laurent68k/RedBoard6809-1/Hardware/Gallery/P2240087.jpg

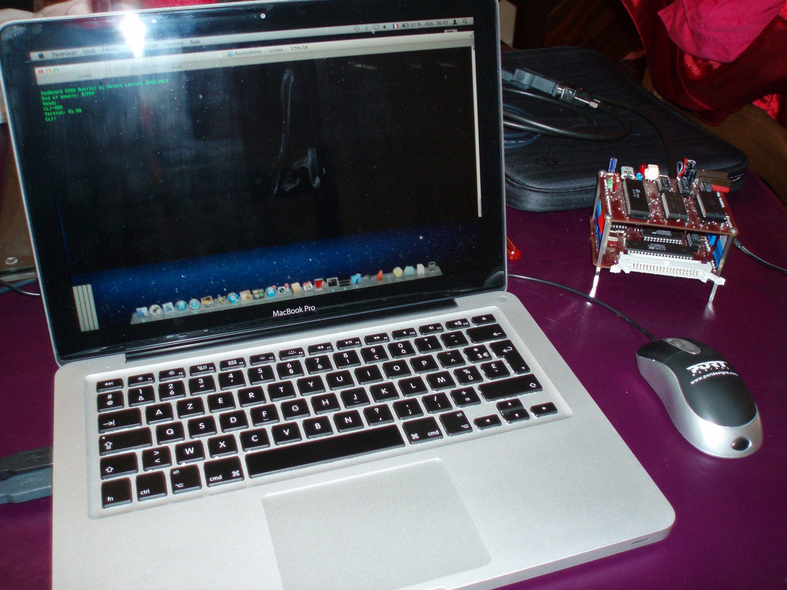
Hardware/Gallery/P2240087.jpg
