laurent68k/RedBoard6809-1/Hardware/Gallery/RBMonitor01.png

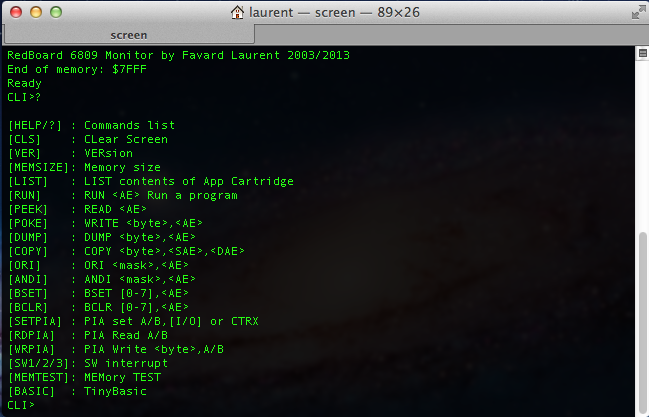
Hardware/Gallery/RBMonitor01.png
