laurent68k/RedBoard6809-1/Hardware/Gallery/P2240088.jpg

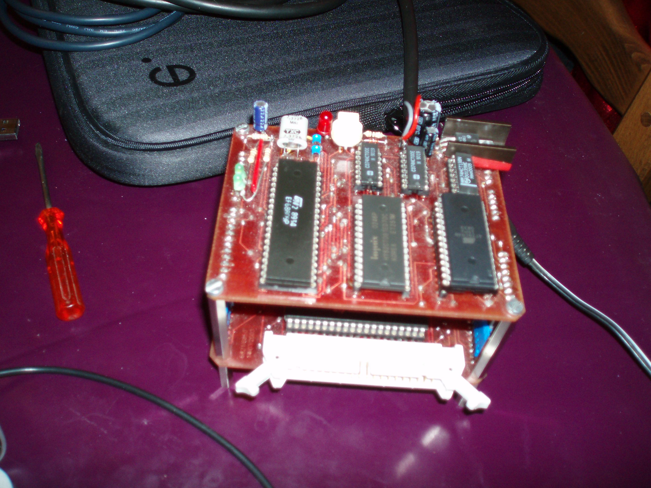
Hardware/Gallery/P2240088.jpg
