laurent68k/RedBoard6809-1/Hardware/Gallery/P3100010.jpg

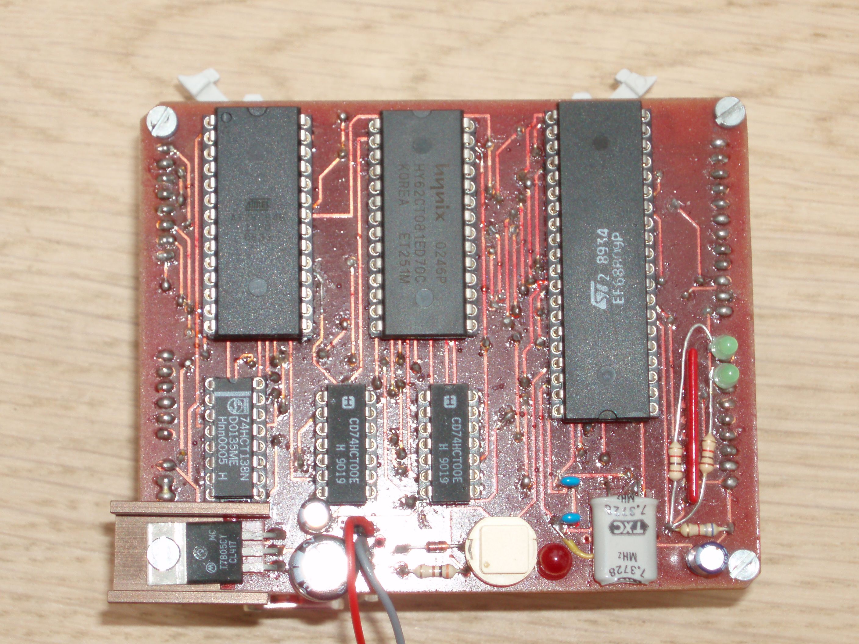
Hardware/Gallery/P3100010.jpg
