laurent68k/RedBoard6809-1/Hardware/Gallery/P3100011.jpg

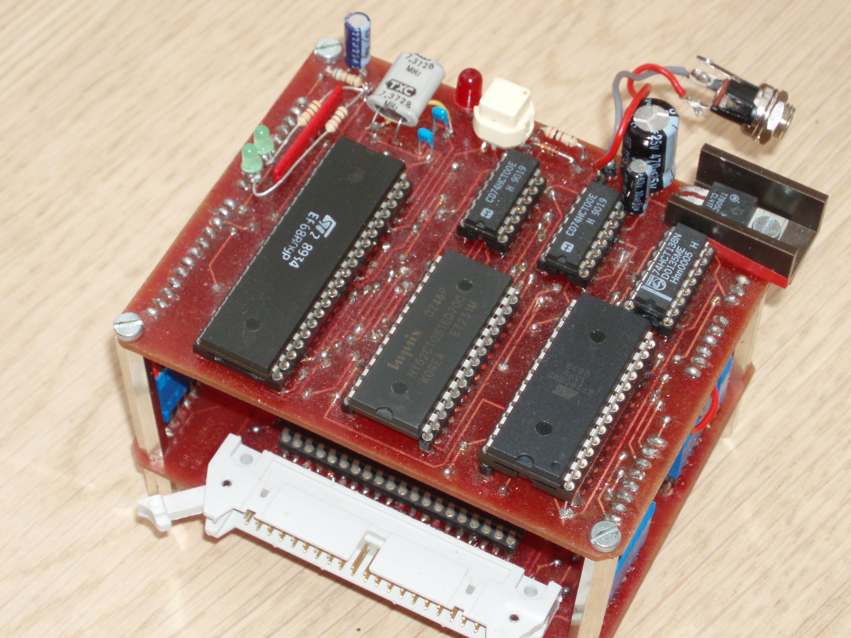
Hardware/Gallery/P3100011.jpg
