laurent68k/RedBoard6809-1/Hardware/Gallery/P3100013.jpg

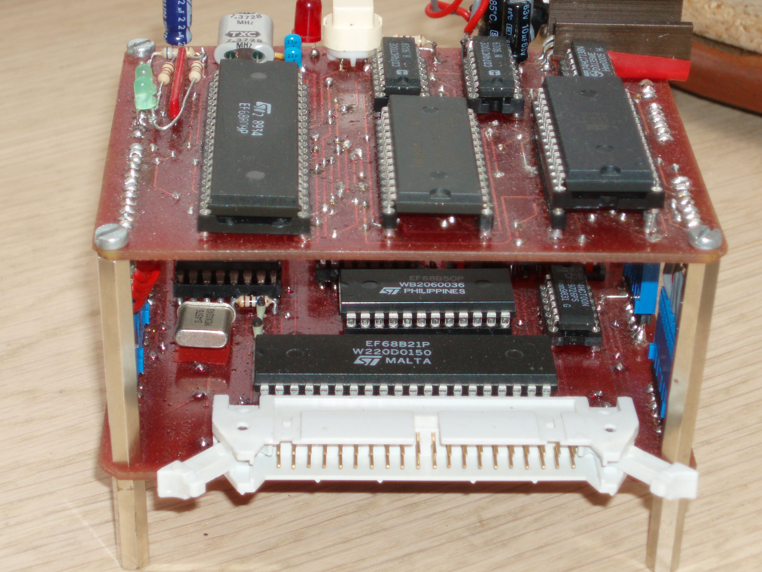
Hardware/Gallery/P3100013.jpg
