laurent68k/RedBoard6809-1/Hardware/Gallery/PC290011.jpg

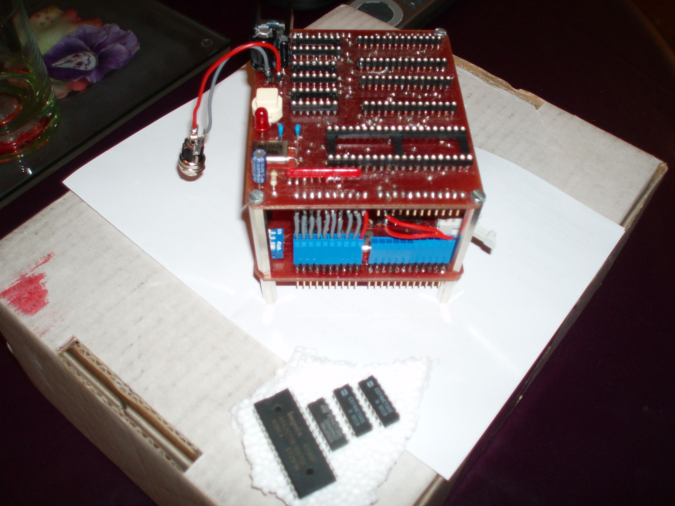
Hardware/Gallery/PC290011.jpg
