laurent68k/RedBoard6809-1/Hardware/Gallery/PC300019.jpg

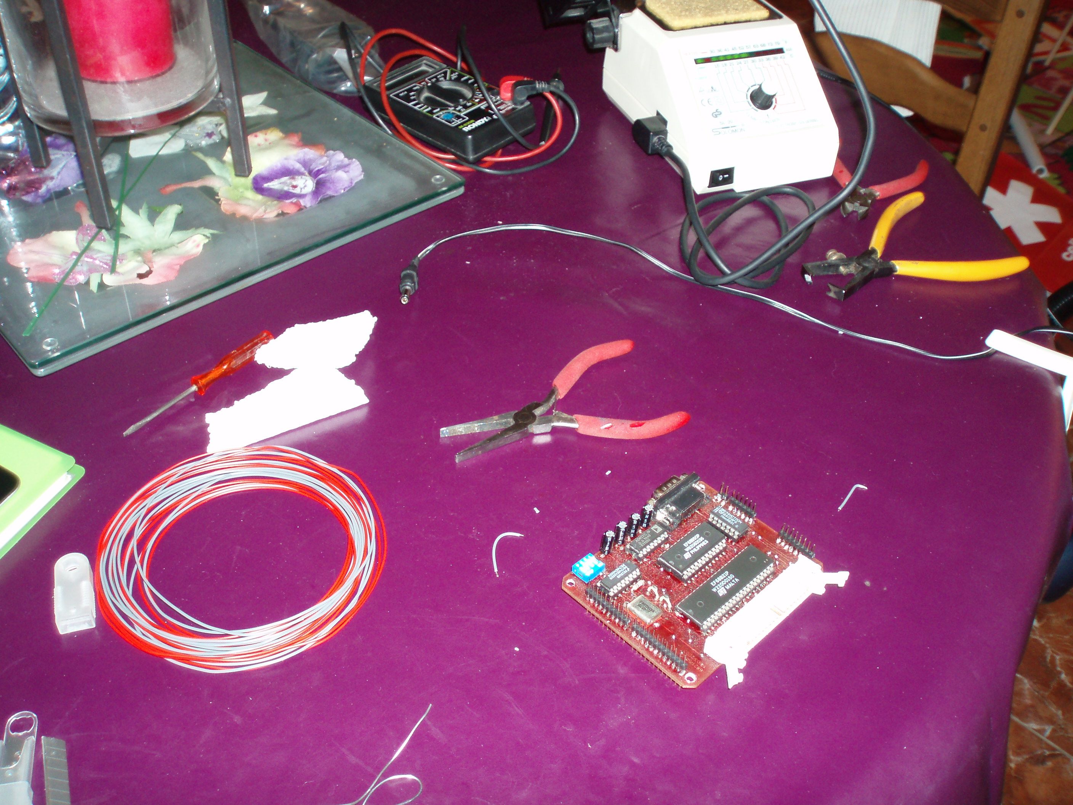
Hardware/Gallery/PC300019.jpg
