laurent68k/RedBoard6809-1/Hardware/Gallery/RBMonitor02.png

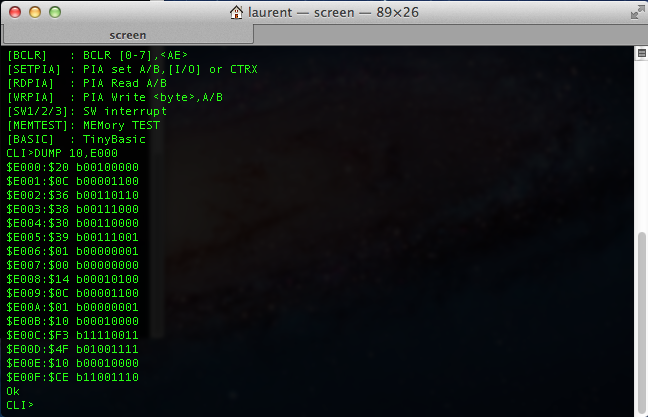
Hardware/Gallery/RBMonitor02.png
