laurent68k/RedBoard6809-1/Hardware/Gallery/RBMonitor03.png

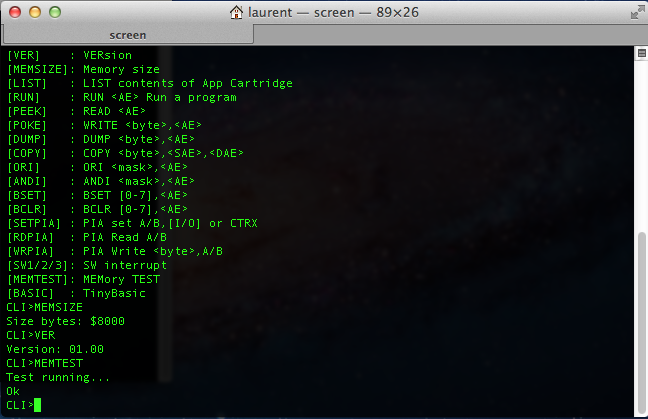
Hardware/Gallery/RBMonitor03.png
