laurent68k/RedBoard6809-1/Hardware/Schematics/CPU-68B09P.png

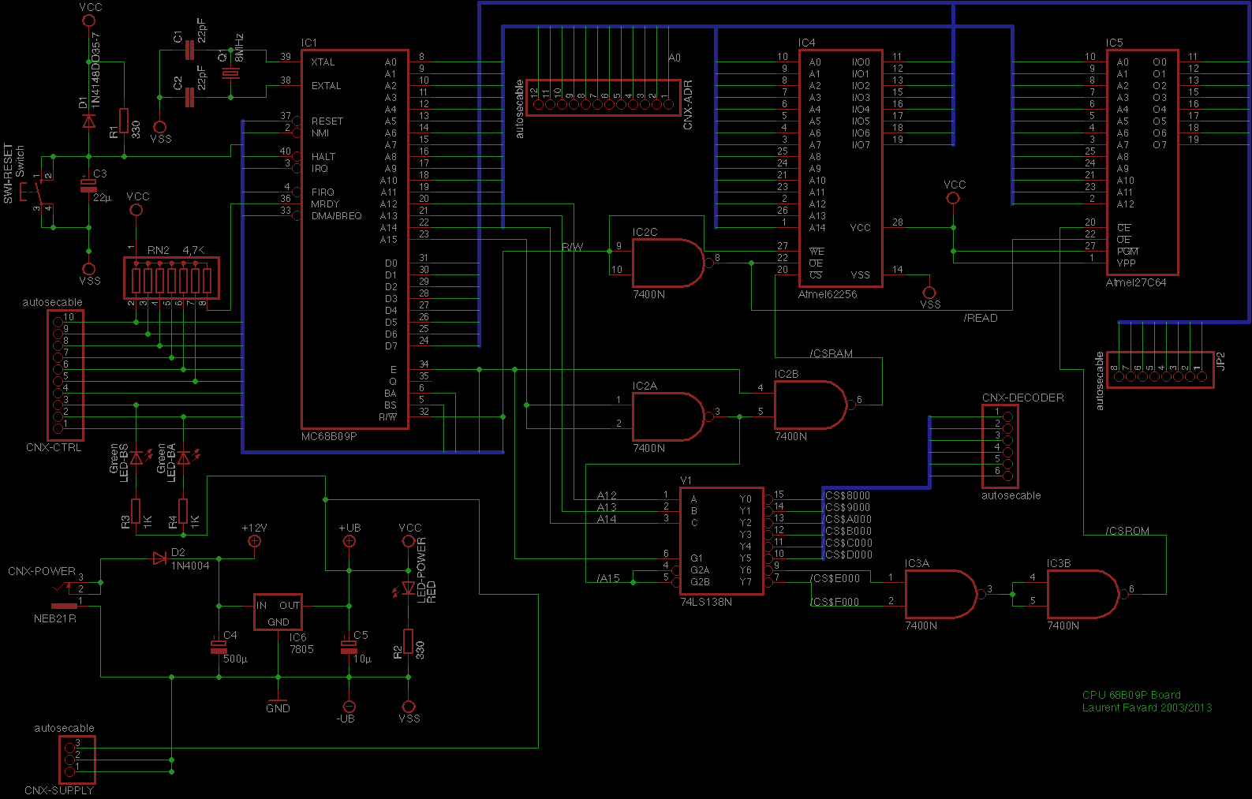
Hardware/Schematics/CPU-68B09P.png
