laurent68k/RedBoard6809-1/Hardware/Schematics/IO-68B50-68B21.jpeg

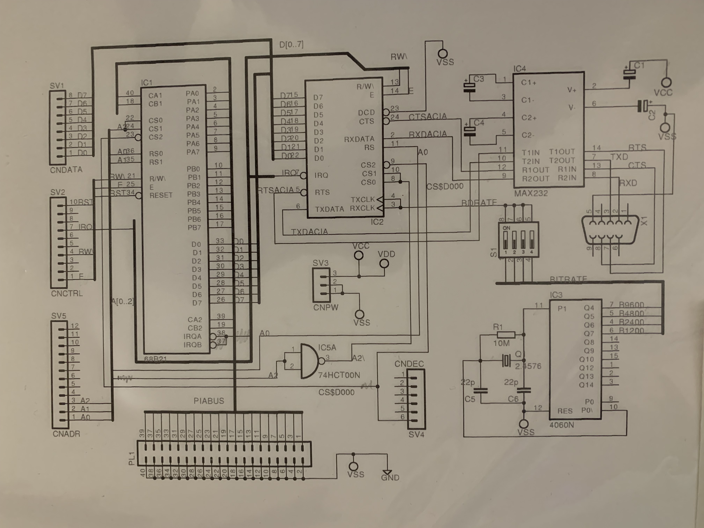
Hardware/Schematics/IO-68B50-68B21.jpeg
