laurent68k/RedBoard6809-1/Hardware/Schematics/eagle/RedBoardCPU6809.sch

## EAGLE design Hardware/Schematics/eagle/RedBoardCPU6809.sch (2025-07-22)

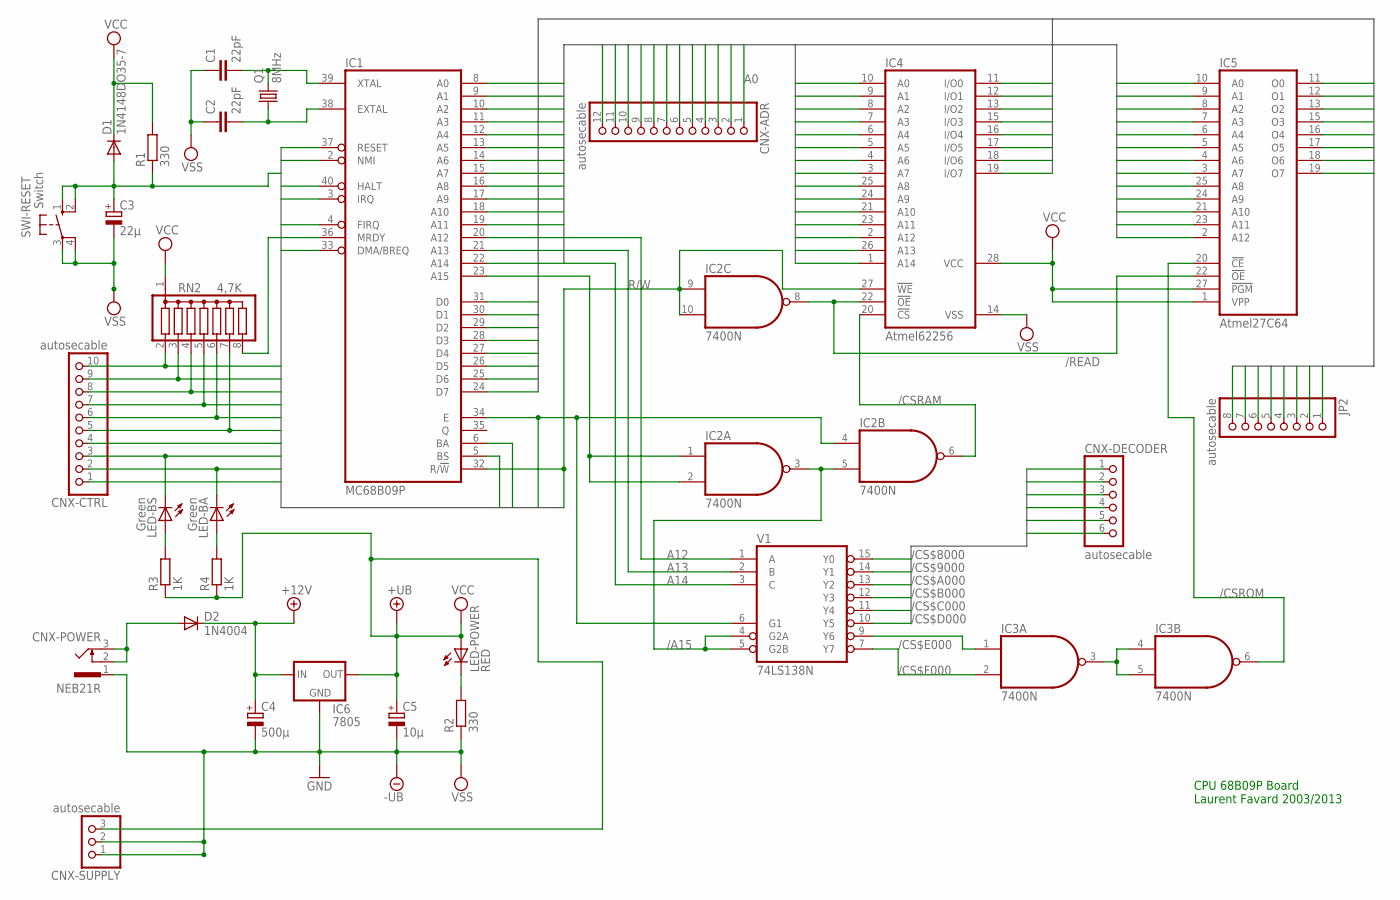
[picture p23: schematic RedBoardCPU6809.sch]

Parts:
C1, C2: 22pF; C2.5-3
C3: 22µ; E2-5
C4: 500µ; E2-5
C5: 10µ; E2-5
CNX-ADR: autosecable; 1X12
CNX-CTRL: autosecable; 1X10
CNX-DECODER: autosecable; 1X06
CNX-POWER: NEB21R
CNX-SUPPLY: autosecable; 1X03
D1: 1N4148DO35-7; DO35-7
D2: 1N4004; DO41-10
IC1: MC68B09P; DIL40
IC2, IC3: 7400N; DIL14
IC4: Atmel62256; DIL28-6
IC5: Atmel27C64; DIL28
IC6: 7805; 78XXL
JP2: autosecable; 1X08
LED-BA: Green; LED3MM
LED-BS: Green; LED3MM
LED-POWER: RED; LED3MM
Q1: 8MHz; HC18U-H
R1, R2: 330; 0207/12
R3, R4: 1K; 0207/12
RN2: 4,7K; SIL8
SWI-RESET: Switch; B3F-10XX
V1: 74LS138N; DIL16

Connections:
+12V: C4.+, D2.C, IC6.IN
/A15: IC2.3 (O), IC2.5 (I1), V1.4 (G2A), V1.5 (G2B)
/CS$8000: CNX-DECODER.1, V1.15 (Y0)
/CS$9000: CNX-DECODER.2, V1.14 (Y1)
/CS$A000: CNX-DECODER.3, V1.13 (Y2)
/CS$B000: CNX-DECODER.4, V1.12 (Y3)
/CS$C000: CNX-DECODER.5, V1.11 (Y4)
/CS$D000: CNX-DECODER.6, V1.10 (Y5)
/CS$E000: IC3.1 (I0), V1.9 (Y6)
/CS$F000: IC3.2 (I1), V1.7 (Y7)
/CSRAM: IC2.6 (O), IC4.20 (!CS)
/CSROM: IC3.6 (O), IC5.20 (!CE)
/READ: IC2.8 (O), IC4.22 (!OE), IC5.22 (!OE)
A0: CNX-ADR.1, IC1.8 (A0), IC4.10 (A0), IC5.10 (A0)
A1: CNX-ADR.2, IC1.9 (A1), IC4.9 (A1), IC5.9 (A1)
A2: CNX-ADR.3, IC1.10 (A2), IC4.8 (A2), IC5.8 (A2)
A3: CNX-ADR.4, IC1.11 (A3), IC4.7 (A3), IC5.7 (A3)
A4: CNX-ADR.5, IC1.12 (A4), IC4.6 (A4), IC5.6 (A4)
A5: CNX-ADR.6, IC1.13 (A5), IC4.5 (A5), IC5.5 (A5)
A6: CNX-ADR.7, IC1.14 (A6), IC4.4 (A6), IC5.4 (A6)
A7: CNX-ADR.8, IC1.15 (A7), IC4.3 (A7), IC5.3 (A7)
A8: CNX-ADR.9, IC1.16 (A8), IC4.25 (A8), IC5.25 (A8)
A9: CNX-ADR.10, IC1.17 (A9), IC4.24 (A9), IC5.24 (A9)
A10: CNX-ADR.11, IC1.18 (A10), IC4.21 (A10), IC5.21 (A10)
A11: CNX-ADR.12, IC1.19 (A11), IC4.23 (A11), IC5.23 (A11)
A12: IC1.20 (A12), IC4.2 (A12), IC5.2 (A12), V1.1 (A)
A13: IC1.21 (A13), IC4.26 (A13), V1.2 (B)
A14: IC1.22 (A14), IC4.1 (A14), V1.3 (C)
BA: CNX-CTRL.2, IC1.6 (BA), LED-BA.K (C)
BS: CNX-CTRL.3, IC1.5 (BS), LED-BS.K (C)
D0: IC1.31 (D0), IC4.11 (I/O0), IC5.11 (O0), JP2.1
D1: IC1.30 (D1), IC4.12 (I/O1), IC5.12 (O1), JP2.2
D2: IC1.29 (D2), IC4.13 (I/O2), IC5.13 (O2), JP2.3
D3: IC1.28 (D3), IC4.15 (I/O3), JP2.4
D4: IC1.27 (D4), IC4.16 (I/O4), IC5.15 (O3), IC5.16 (O4), JP2.5
D5: IC1.26 (D5), IC5.17 (O5), JP2.6
D6: IC1.25 (D6), IC4.18 (I/O6), IC5.18 (O6), JP2.7
D7: IC1.24 (D7), IC4.17 (I/O5), IC4.19 (I/O7), IC5.19 (O7), JP2.8
DMA/BREQ: CNX-CTRL.5, IC1.33 (DMA/BREQ), RN2.7
E: CNX-CTRL.1, IC1.34 (E), IC2.4 (I0), V1.6 (G1)
FIRQ: CNX-CTRL.6, IC1.4 (FIRQ), RN2.6
HALT: CNX-CTRL.8, IC1.40 (HALT), RN2.4
IRQ: CNX-CTRL.7, IC1.3 (IRQ), RN2.5
unnamed: C1.2, IC1.39 (XTAL), Q1.2
unnamed: LED-BS.A, R3.2
unnamed: IC1.23 (A15), IC2.1 (I0), IC2.2 (I1)
unnamed: CNX-POWER.2, CNX-POWER.3, D2.A
unnamed: C2.2, IC1.38 (EXTAL), Q1.1
unnamed: LED-BA.A, R4.2
unnamed: LED-POWER.K (C), R2.2
unnamed: IC3.3 (O), IC3.4 (I0), IC3.5 (I1)
unnamed: IC1.36 (MRDY), RN2.8
NMI: CNX-CTRL.9, IC1.2 (NMI), RN2.3
R/W: CNX-CTRL.4, IC1.32 (R/!W), IC2.9 (I0), IC2.10 (I1), IC4.27 (!WE)
RESET: C3.+, CNX-CTRL.10, D1.A, IC1.37 (RESET), R1.1, RN2.2, SWI-RESET.1 (S), SWI-RESET.2 (S1)
VCC: C5.+, CNX-SUPPLY.3, D1.C, IC4.28 (VCC), IC5.1 (VPP), IC5.27 (!PGM), IC6.OUT, LED-POWER.A, R1.2, R3.1, R4.1, RN2.1
VSS: C1.1, C2.1, C3.-, C4.-, C5.-, CNX-POWER.1, CNX-SUPPLY.1, CNX-SUPPLY.2, IC4.14 (VSS), IC6.GND, R2.1, SWI-RESET.3, SWI-RESET.4 (P1)

Notes on the sheet:
CPU 68B09P Board Laurent Favard 2003/2013
