laurent68k/RedBoard6809-1/(commit log)

2025-07-22 brings together all the elements concerning this project
    [RedBoardCPU6809.sch]
2025-11-08 originals schematics CPU and IO added
